raphschwarz/Ears-0603/Ears 0603.brd

## EAGLE design Ears 0603.brd (2018-03-17)

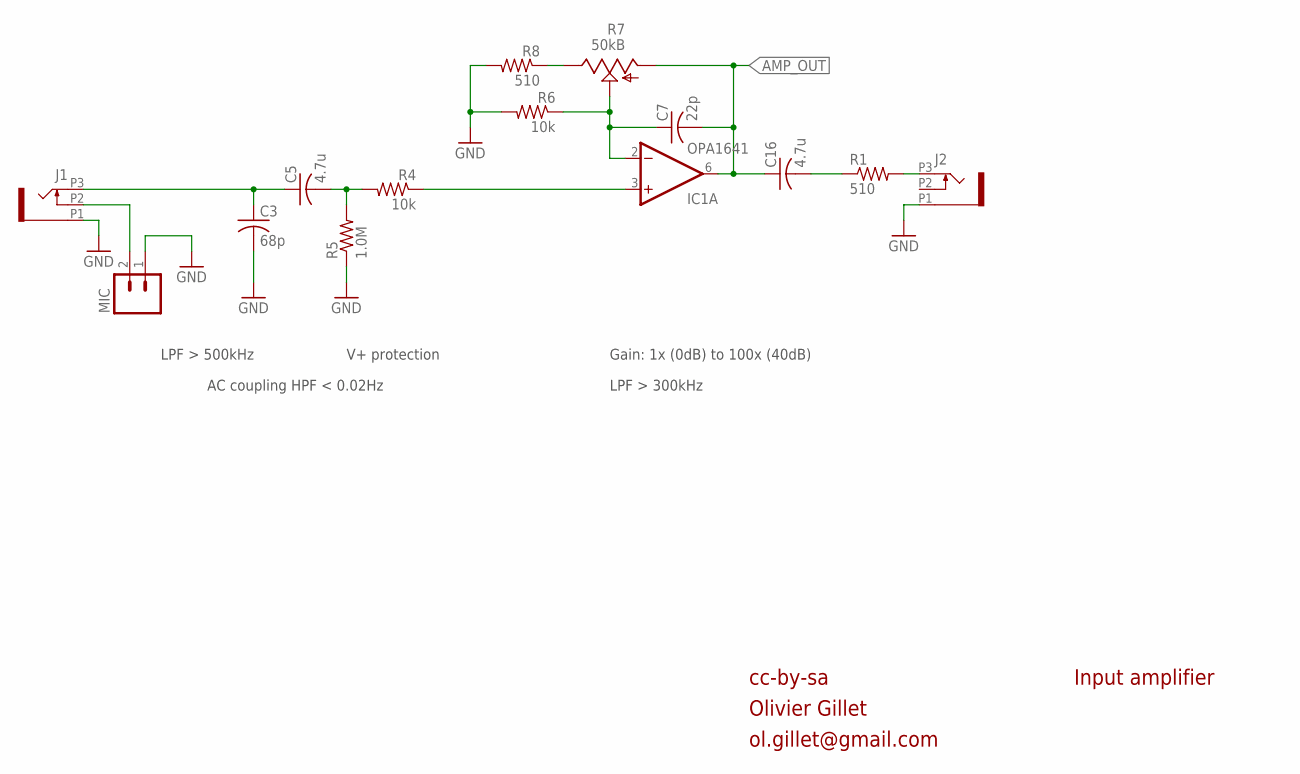
[picture p1: schematic Ears 0603.sch, sheet 1]

Parts:
C3: 68p; C0603
C5, C16: 4.7u; C0603
C7: 22p; C0603
IC1: OPA1641; MSOP8
J1, J2: PJ301_THONKICONN6; WQP_PJ_301M6
MIC: M02TINY; 1X02_TINY
R1, R8: 510; R0603
R4, R6: 10k; R0603
R5: 1.0M; R0603
R7: 50kB; ALPS_POT_VERTICAL_PS

Connections:
AMP_OUT: C7.2, C16.1, IC1.6 (OUT), R7.P$3 (A); also elsewhere on the board
GND: C3.2, J1.P1 (1), J2.P1 (1), MIC.1, R5.1, R6.2, R8.2; also elsewhere on the board
unnamed: IC1.3 (+IN), R4.1
unnamed: J2.P3 (3), R1.2
unnamed: C3.1, C5.1, J1.P3 (3)
unnamed: J1.P2 (2), MIC.2
unnamed: C7.1, IC1.2 (-IN), R6.1, R7.P$2 (S)
unnamed: C5.2, R4.2, R5.2
unnamed: R7.P$1 (E), R8.1
unnamed: C16.2, R1.1

Notes on the sheet:
cc-by-sa
Olivier Gillet
ol.gillet@gmail.com
Input amplifier
Gain: 1x (0dB) to 100x (40dB)
LPF > 500kHz
V+ protection
LPF > 300kHz
AC coupling HPF < 0.02Hz

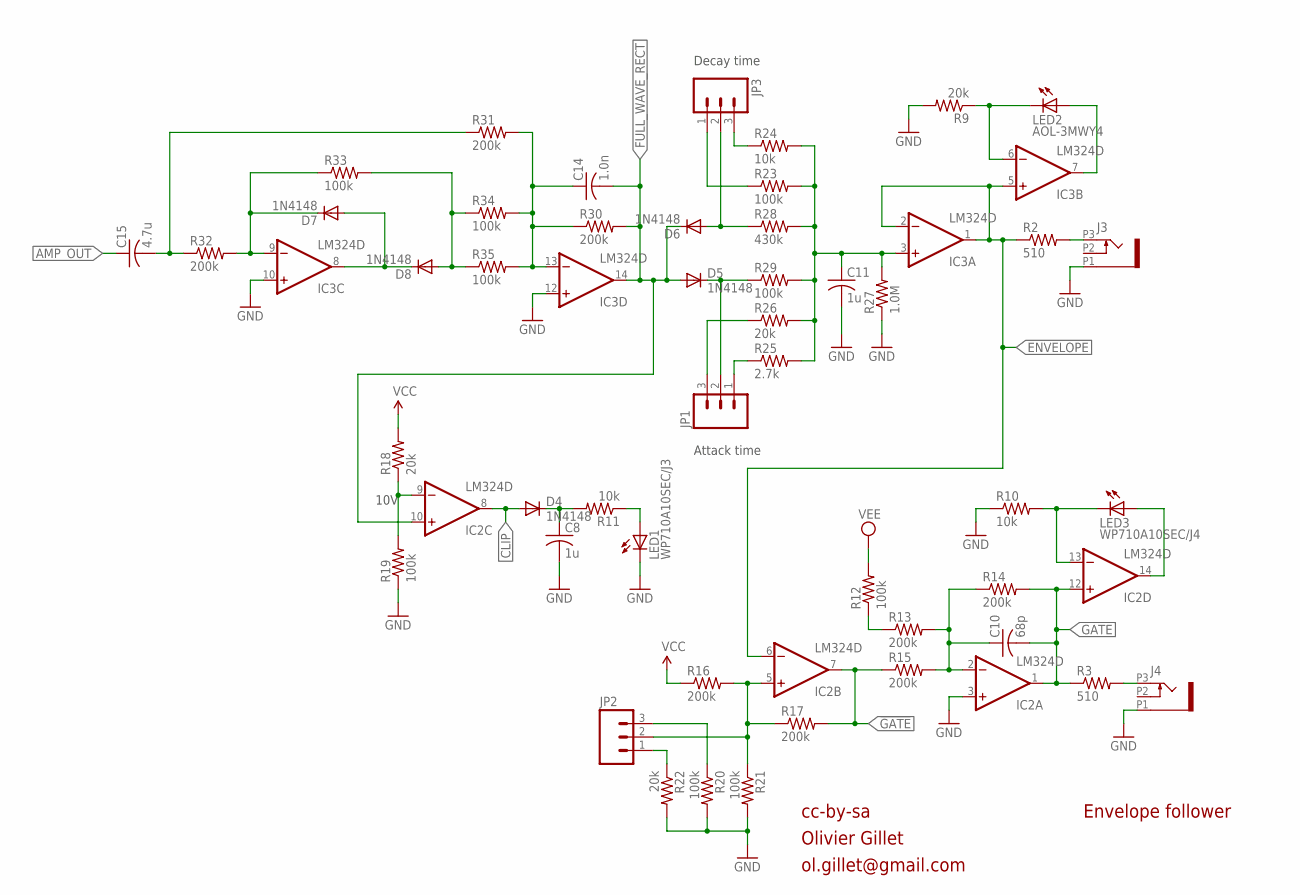
[picture p2: schematic Ears 0603.sch, sheet 2]

Parts:
C8, C11: 1u; C0603
C10: 68p; C0603
C14: 1.0n; C0603
C15: 4.7u; C0603
D4, D5, D6, D7, D8: 1N4148; SOD323-W
IC2, IC3: LM324D; SO14
J3, J4: PJ301_THONKICONN6; WQP_PJ_301M6
JP1, JP2, JP3: M03PTH; 1X03
LED1: WP710A10SEC/J3; LED3MM
LED2: AOL-3MWY4; LED3MM
LED3: WP710A10SEC/J4; LED3MM
R2, R3: 510; R0603
R9, R18, R22, R26: 20k; R0603
R10, R11, R24: 10k; R0603
R12, R19, R20, R21, R23, R29, R33, R34, R35: 100k; R0603
R13, R14, R15, R16, R17, R30, R31, R32: 200k; R0603
R25: 2.7k; R0603
R27: 1.0M; R0603
R28: 430k; R0603

Connections:
!GATE: IC2.7 (OUT), R15.1, R17.2
AMP_OUT: C15.1; also elsewhere on the board
AMP_OUT_AC: C15.2, R31.1, R32.1
CLIP: D4.A, IC2.8 (OUT)
ENVELOPE: IC2.6 (-IN), IC3.1 (OUT), IC3.2 (-IN), IC3.5 (+IN), R2.1
FULL_WAVE_RECT: C14.2, D5.A, D6.C, IC2.10 (+IN), IC3.14 (OUT), R30.2
GATE: C10.2, IC2.1 (OUT), IC2.12 (+IN), R3.1, R14.2
GND: C8.2, C11.2, IC2.3 (+IN), IC3.10 (+IN), IC3.12 (+IN), J3.P1 (1), J4.P1 (1), LED1.K (C), R9.2, R10.1, R19.1, R20.2, R21.2, R22.2, R27.1; also elsewhere on the board
unnamed: D7.A, D8.C, IC3.8 (OUT)
unnamed: C10.1, IC2.2 (-IN), R13.2, R14.1, R15.2
unnamed: D7.C, IC3.9 (-IN), R32.2, R33.1
unnamed: D8.A, R33.2, R34.1, R35.1
unnamed: C14.1, IC3.13 (-IN), R30.1, R31.2, R34.2, R35.2
unnamed: J3.P3 (3), R2.2
unnamed: IC3.6 (-IN), LED2.K (C), R9.1
unnamed: D5.C, JP1.2, R29.1
unnamed: C11.1, IC3.3 (+IN), R23.2, R24.2, R25.2, R26.2, R27.2, R28.2, R29.2
unnamed: JP3.3, R24.1
unnamed: JP3.1, R23.1
unnamed: D6.A, JP3.2, R28.1
unnamed: JP1.1, R25.1
unnamed: JP1.3, R26.1
unnamed: IC2.9 (-IN), R18.1, R19.2
unnamed: C8.1, D4.C, R11.2
unnamed: IC3.7 (OUT), LED2.A
unnamed: LED1.A, R11.1
unnamed: J4.P3 (3), R3.2
unnamed: IC2.5 (+IN), JP2.2, R16.2, R17.1, R21.1
unnamed: JP2.1, R22.1
unnamed: JP2.3, R20.1
unnamed: IC2.13 (-IN), LED3.K (C), R10.2
unnamed: IC2.14 (OUT), LED3.A
unnamed: R12.1, R13.1
VCC: R16.1, R18.2; also elsewhere on the board
VEE: R12.2; also elsewhere on the board

Notes on the sheet:
cc-by-sa
Olivier Gillet
ol.gillet@gmail.com
Envelope follower
Decay time
Attack time
10V

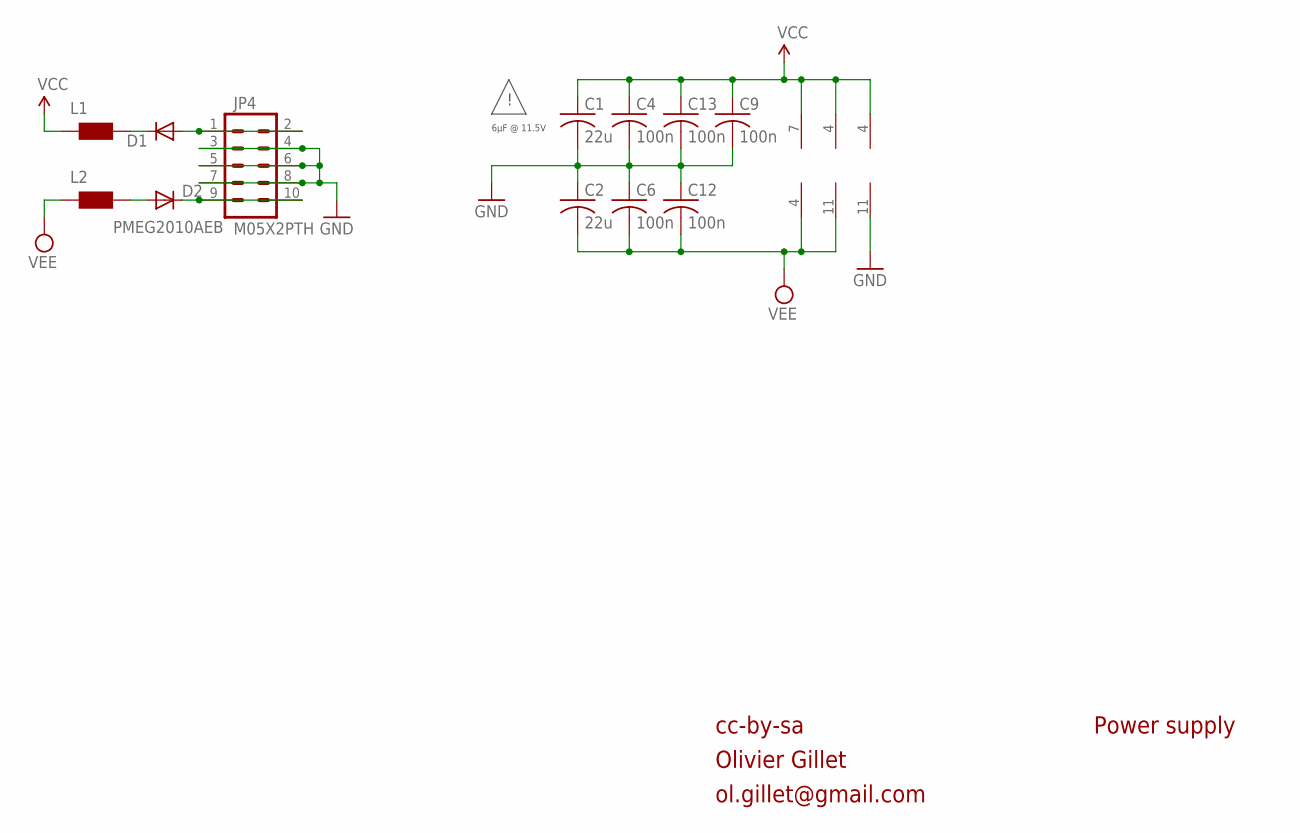
[picture p3: schematic Ears 0603.sch, sheet 3]

Parts:
C1, C2: 22u; C1206
C4, C6, C9, C12, C13: 100n; C0603
D1, D2: PMEG2010AEB; SOD323-W
IC1: OPA1641; MSOP8
IC2, IC3: LM324D; SO14
JP4: M05X2PTH; AVR_ICSP
L1, L2: WE-CBF_0603; 0603

Connections:
GND: C1.2, C2.1, C4.2, C6.1, C9.2, C12.1, C13.2, IC2.11 (V-), JP4.3, JP4.4, JP4.5, JP4.6, JP4.7, JP4.8; also elsewhere on the board
unnamed: D1.A, JP4.1, JP4.2
unnamed: D2.C, JP4.9, JP4.10
unnamed: D1.C, L1.2
unnamed: D2.A, L2.2
VCC: C1.1, C4.1, C9.1, C13.1, IC1.7 (V+), IC2.4 (V+), IC3.4 (V+), L1.1; also elsewhere on the board
VEE: C2.2, C6.2, C12.2, IC1.4 (V-), IC3.11 (V-), L2.1; also elsewhere on the board

Notes on the sheet:
cc-by-sa
Olivier Gillet
ol.gillet@gmail.com
Power supply
6µF @ 11.5V

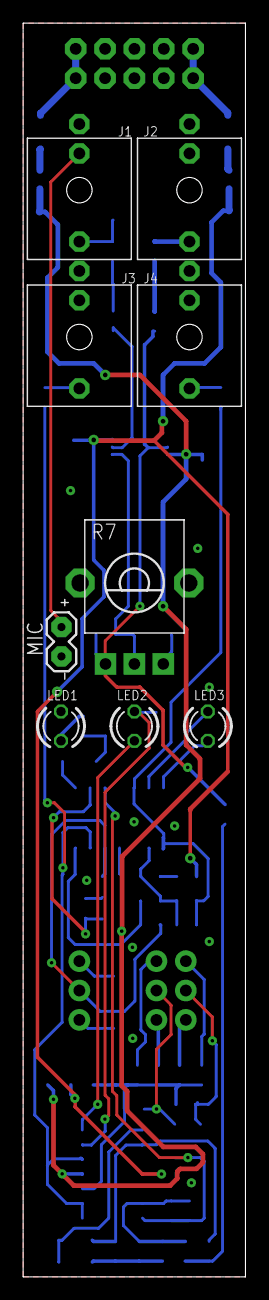
[picture p4: board Ears 0603.brd from above]

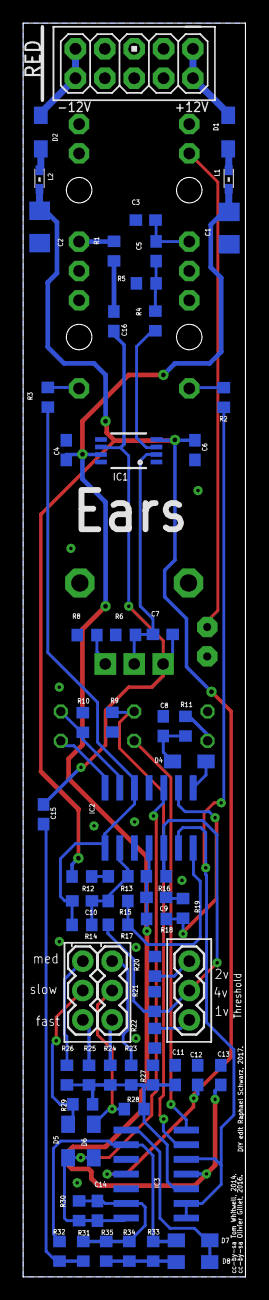
[picture p5: board Ears 0603.brd from below]

Board: 2 copper layers, 19.2 x 108.4 mm, 75 parts (66 on the bottom side), 47 nets.
