raphschwarz/Ears-0603/(notices)

Notices in the files:
Ears 0603.brd:
cc-by-sa Olivier Gillet, 2016.
cc-by-sa Tom Whitwell, 2014.
